nickdpz/Control-de-Rectificador-Trifasico-6-scr-s-PIC16F628A/README.md

Control de Rectificador Trifasico 6 scr s PIC16F628A. /
El sistema constara de tres etapas: 1) la etapa de control y sincronización 2) la etapa de drive y por último 3) la etapa de potencia, estas se explicarán detalladamente en el archivo PDF llamado informe, ademas se podra ver el esquema final en el archivo PDF Esquematico-Trifasico
