nickdpz/Control-de-Rectificador-Trifasico-6-scr-s-PIC16F628A/Informe.pdf

Objetivos

Generales

- Diseñar e implementar un rectificador trifásico totalmente controlado con carga resistiva y voltaje de fase 120Vrms.
- Diseñar el circuito de control de tal forma que el ángulo de disparo se pueda modificar de 0 a 180° con respecto al ángulo mínimo de disparo. De tal forma que se pueda usar para transmisión de corriente continua en configuración back to back.

Específicos

- Seleccionar los SCR’ s que permita entregar la corriente que requerida por la carga y soporte las tensiones trifásicas de bloqueo.
- Identificar los requerimientos para disparar los SCR’ s de un circuito de potencia, donde su cátodo no está referenciado a la tierra del circuito.
- Diseñar un circuito que permita identifique de las señales trifásicas el momento donde se tiene el ángulo mínimo para los disparos.
- Proponer un circuito que permita disparar de forma controlada los 6 SCR´ s del rectificador trifásico.
- Diseñar una etapa drive que de potencia a los disparos generados por la etapa de control hacia la etapa de potencia y aislé las tierras de ambas etapas.

Planteamiento del Problema
Se debe diseñar un rectificador trifásico controlado para una carga resistiva en este caso un bombillo. El nivel Tensión de trabajo Fase a Neutro es 120Vrms, y lo que se desea es la modificación manual del ángulo disparo alfa (α).

Solución

El sistema constara de tres etapas: 1) la etapa de control y sincronización 2) la etapa de drive y por último 3) la etapa de potencia, estas se explicarán detalladamente a continuación:

Etapa de Control y Sincronización

Debido a las alteraciones leves que presenta la red en cuanto a frecuencia o niveles de señal, es necesario sincronizar constantemente, de modo es muy importante para el diseño de la etapa de control cómo y en que instante del periodo de la señal nos vamos a sincronizar.

La sincronización se puede hacer en dos instantes de la señal, el primer caso sería encontrar el cruce por cero de la señal de referencia para este caso R y con un circuito análogo o digital hacer un retardo de 60° para encontrar el alfa mínimo, sin embargo, esta alternativa necesita gastar algo de recursos del circuito digital o un circuito extra análogo. Otra alternativa para diseño es un comparador entre las fases y que se active en el instante donde la fase R sea la mayor de todas, esta alternativa es la que se va a aplicar al circuito propuesto.

# Rectificador Trifásico Totalmente controlado

Nicolas David Pastran Zamora | Cod. 20151005087
Benigno Alexander Corrales | Cod. 20142005093
Universidad Distrital Francisco José de Caldas, Facultad de Ingeniería Laboratorio de Electrónica de Potencia
Bogotá, Colombia

Si notamos en la señal trifásica el instante donde R es mayor que S y que T, es el mismo donde R es mayor a T como se ve en la figura 1.

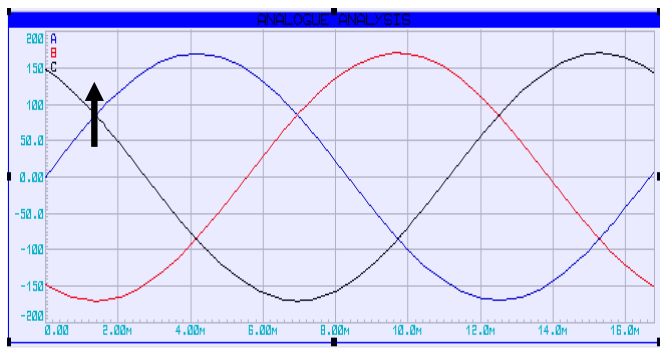
[picture p1: figure]

Figura 1: Identificación de ángulo mínimo de disparo

Para identificar ese instante usaremos un amplificador operacional como comparador con su respectivo acondicionamiento de señales.

Como la salida del operacional va a ir a la entrada de un microcontrolador este debe estar en un rango entre 0 y 5 voltios, entonces se debe seleccionar una fuente de alimentación para el operacional, aproximadamente de 6.5V, para el diseño usaremos una de 7 V y un operacional polarizado con fuente única (lm358) para que el Vol sea lo más cercano posible a 0V.

Del acondicionamiento de señales de la entrada tenemos que tener en cuenta que el rango de voltaje debe estar entre 2V y 5V, entonces se debe acondicionar las fases que están en el rango de -170 V y 170V al rango de entrada del operacional. El diseño del acondicionamiento de señales se realiza a continuación:

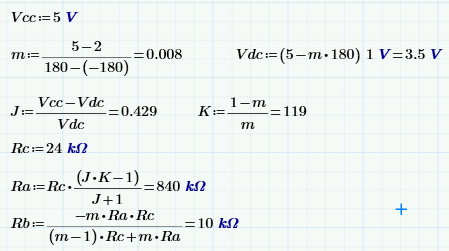
[picture p2: figure]

El circuito Resultante se puede observar en la figura 2.

Es decir, se desea reducir notoriamente la amplitud de las fases y montarlas sobre un nivel D.C. donde solo se presenten valores apropiados para el micro.

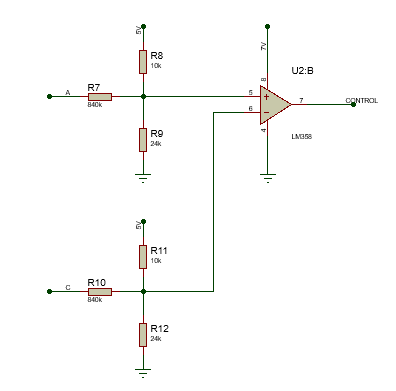
[picture p3: figure]

Figura 2: Entrada del operacional

El circuito presenta como salida un Pwm correspondiente al cruce de señales:

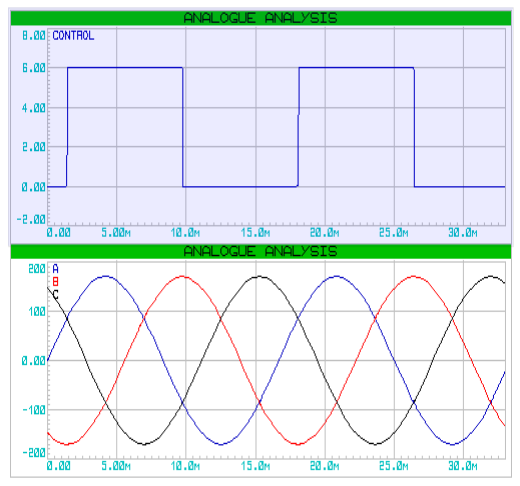
[picture p4: figure]

Figura 3: Red trifásica y salida del opAmp.

La señal de control entonces estará dada por el flanco de subida de la salida del operacional.

Una vez establecida la señal de control se realizará el diseño del circuito encargado de genera los pulsos de disparo para el ángulo seleccionado.

Como circuito encargado de generar los pulsos de disparo se usará un PIC16F628A, ya que cuenta con 2 módulos de conteo timer y módulo de interrupción externa, los cuales se usarán para detectar el flanco de subida, contar el tiempo al cual le corresponde el ángulo de disparo seleccionado y el tiempo que hay entre los pulsos de cada dispositivo. Mientras que el procesador estará encargado de contar el tiempo que duran en alto los pulsos (aproximadamente 300µs) y escuchar cuando se pulse un botón para modificar el ángulo de disparo.

Pines de los puertos A y B de dicho Pic entregaran las salidas controladas.

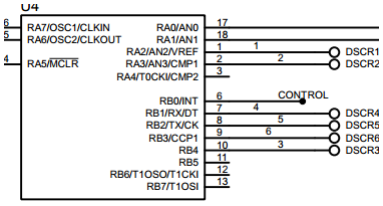
[picture p5: figure]

Figura 4: Pic16f628A

El lenguaje de mayor facilidad e implementado para la programación es C CCs orientado para microcontroladores.

En | términos | generales, | el | amplificador
operacional proporciona un flanco de subida que activa la interrupción, ésta activa un timer contador del tiempo correspondiente al ángulo alfa, culminado ese tiempo se envían pulsos y se activa un segundo timer establecido con el tiempo para la nueva orden de pulsos. Así pues, la interrupción externa garantiza el sincronismo, el primer timer garantiza un alfa variable pues se plantean botones para modificar su parámetro, y el segundo timer tiene parámetro constante y es quien establece los 60 grados entre pulsos.

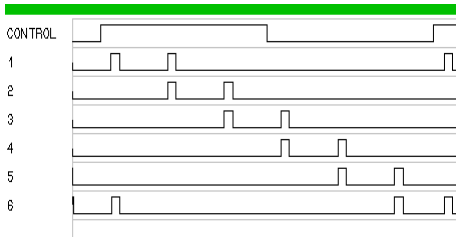
[picture p6: figure]

Figura 5: Salida del opAmp y serie de pulsos

Finalmente, para el circuito se proponen un nivel de tensión de 5 V para el Pic y 7v para el operacional

Etapa Drive:
Como para la detección de cruce señales propuesta, se conecta el neutro de la red trifásica directamente con la tierra de los niveles D.C., se hace necesario la incorporación de elementos de acople de tierras, sin contar que además es imposible conectar los pines del micro directamente a los SCR.

Se presentan transistores npn 2n904 saturados por las salidas del Pic a través de resistencias de 10K en su base. Como carga entre colector y Vcc de 7V, se tiene el primario de un transformador de pulsos. Adicionalmente se tiene como elementos de protección en paralelo al primario un diodo Zener para evitar sobretensiones, y un diodo de conmutación rápida para evitar el efecto conocido patada inductiva (diodo volante).

Así pues, el secundario garantiza una salida apropiada para la conexión con los elementos principales del rectificador los SCR, pues presenta desacople de tierras.

Para garantizar un consumo de corriente se tiene resistencias de 22K entre los terminales de la bobina de salida, y en paralelo a esta, salen un diodo que evita flancos negativos o parásitos generados por el ∆V
∆t

, y una
resistencia de 100 ohms limitando la corriente de gate. La conexión propuesta se repite 6 veces, una por cada SCR.

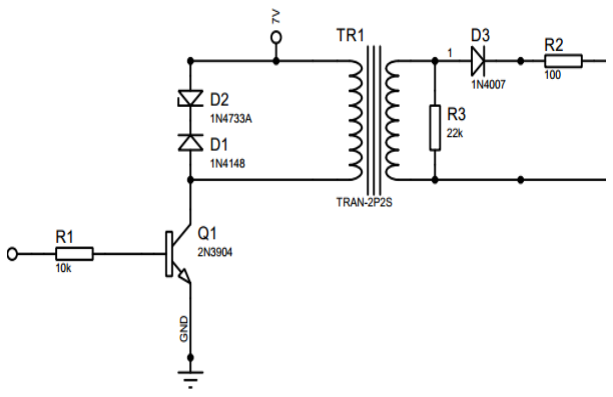
[picture p7: figure]

Figura 6: Etapa drive entre el Pic y los Scr

Etapa Potencia:
Conformada por los SCR, la referencia seleccionada son los TYN412, SCR’s con empaquetado TO-220 y capaces de trabajar con cualquier nivel de tensión no mayor a 400V .
La conexión del rectificador es la propuesta en bibliografías como “Electrónica de Potencia” de Hart, es decir la numeración impar 1,3,5 en la parte superior, y 4,6,2 en la inferior:

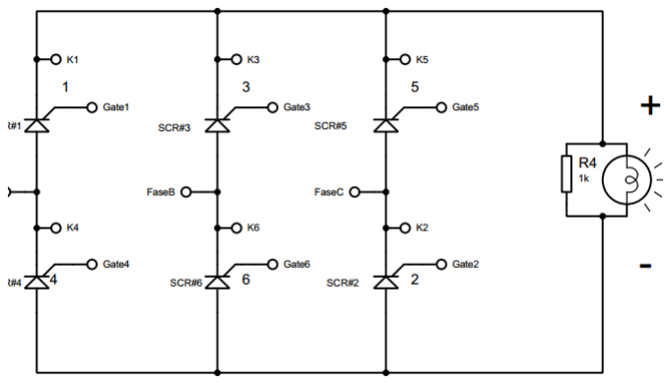
[picture p8: figure]

Figura 7: Conexión de SCR’s

Así pues, cada juego Gate-cátodo está
conectado | a | un | secundario | de | un
transformador de pulsos. Es decir, posee su propio pulso, pero la conexión no es arbitraria pues debe conectarse acorde con el que posee en su primario el pin de control específico del micro.

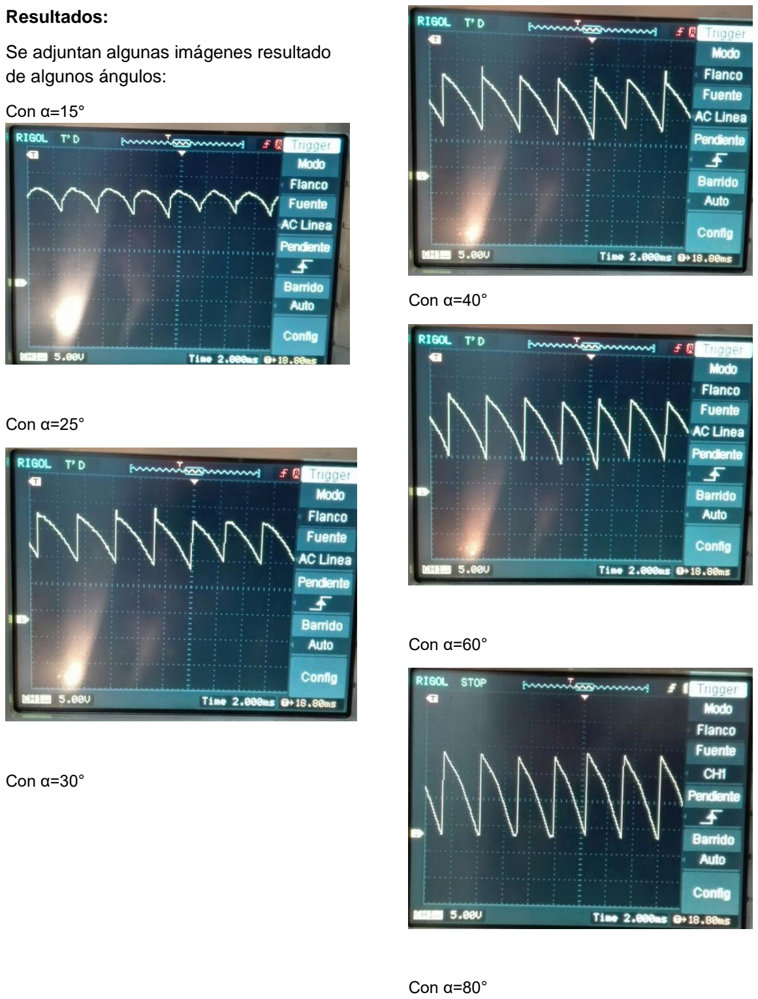
[picture p9: page 5]

Resultados:

Se adjuntan algunas imágenes resultado de algunos ángulos:

Con α=15°

Con α=25°

Con α=30°

Con α=40°

Con α=60°

Con α=80°

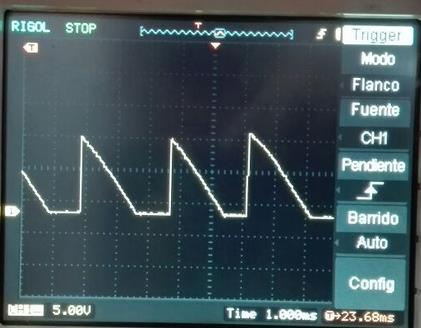
[picture p10: figure]

Conclusiones

- Se realizaron pruebas con pulso sencillo y doble pulso a la entrada de los transformadores, la mejor respuesta en el secundario de los transformadores se obtuvo con el doble pulso, pues como se incrementó la frecuencia se evitó la saturación de los mismos.
- Es importante destacar que el tiempo equivalente a los grados entre pulsos debe estar lo más exacto posible, pues
disparos | erróneos | con | retardo | o
anterioridad causan fluctuaciones e irregularidades con la señal esperada.
- Dada la frecuencia de los pulsos de disparo, es importante que los diodos en la etapa drive sean de conmutación rápida, pues cualquier retardo en tiempo de recuperación inversa aquí si es notorio.
- Los secundarios de los transformadores presentan fluctuaciones bruscas debido a la variación de voltaje, es necesario destacar la necesidad de diodos en
dicha | salida | para | eliminar | picos
negativos

Referencias:

[1]Compilador C CCS y simulador Proteus para microcontroladores PIC – Eduardo García Breijo

[2] Electrónica de potencia. Daniel W. Hart
[3] Apuntes y notas de clase

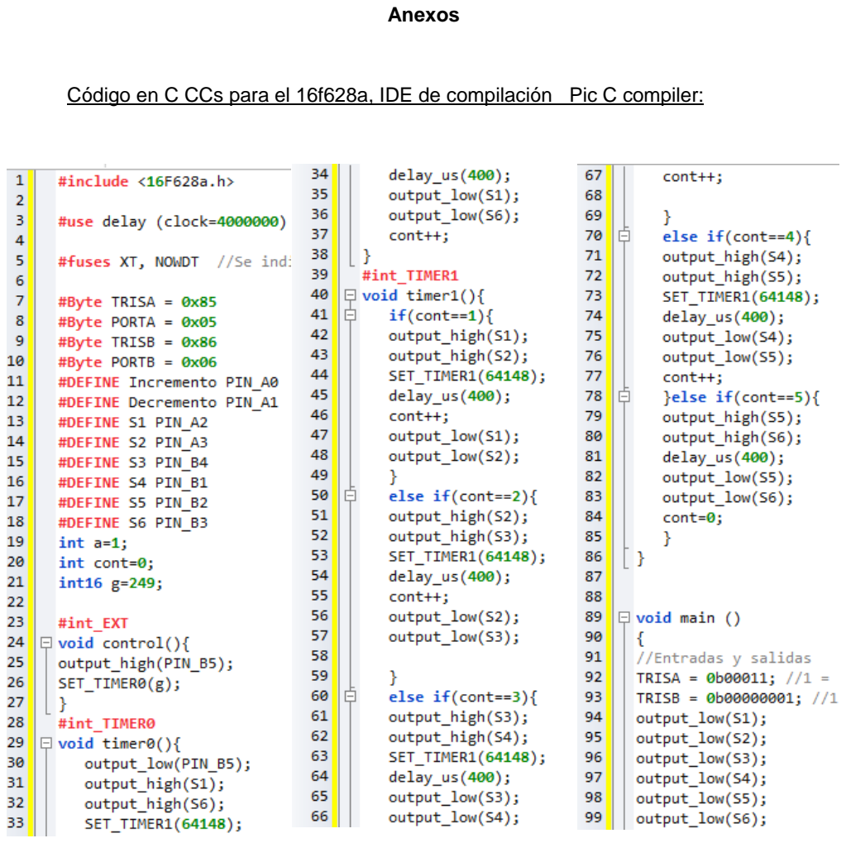
[picture p11: page 7]

Anexos

Código en C CCs para el 16f628a, IDE de compilación Pic C compiler:

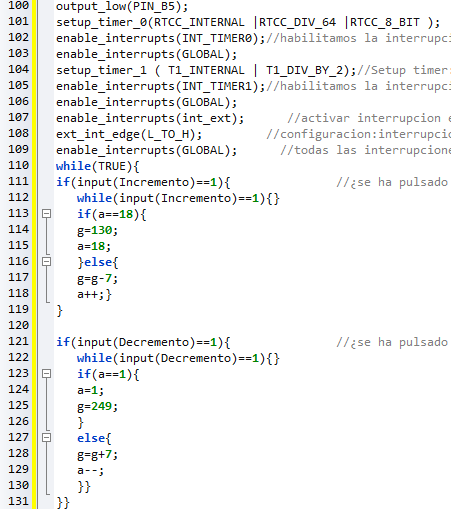
[picture p12: figure]
