nickdpz/Control-de-Rectificador-Trifasico-6-scr-s-PIC16F628A/Esquematico-Trifasico.PDF

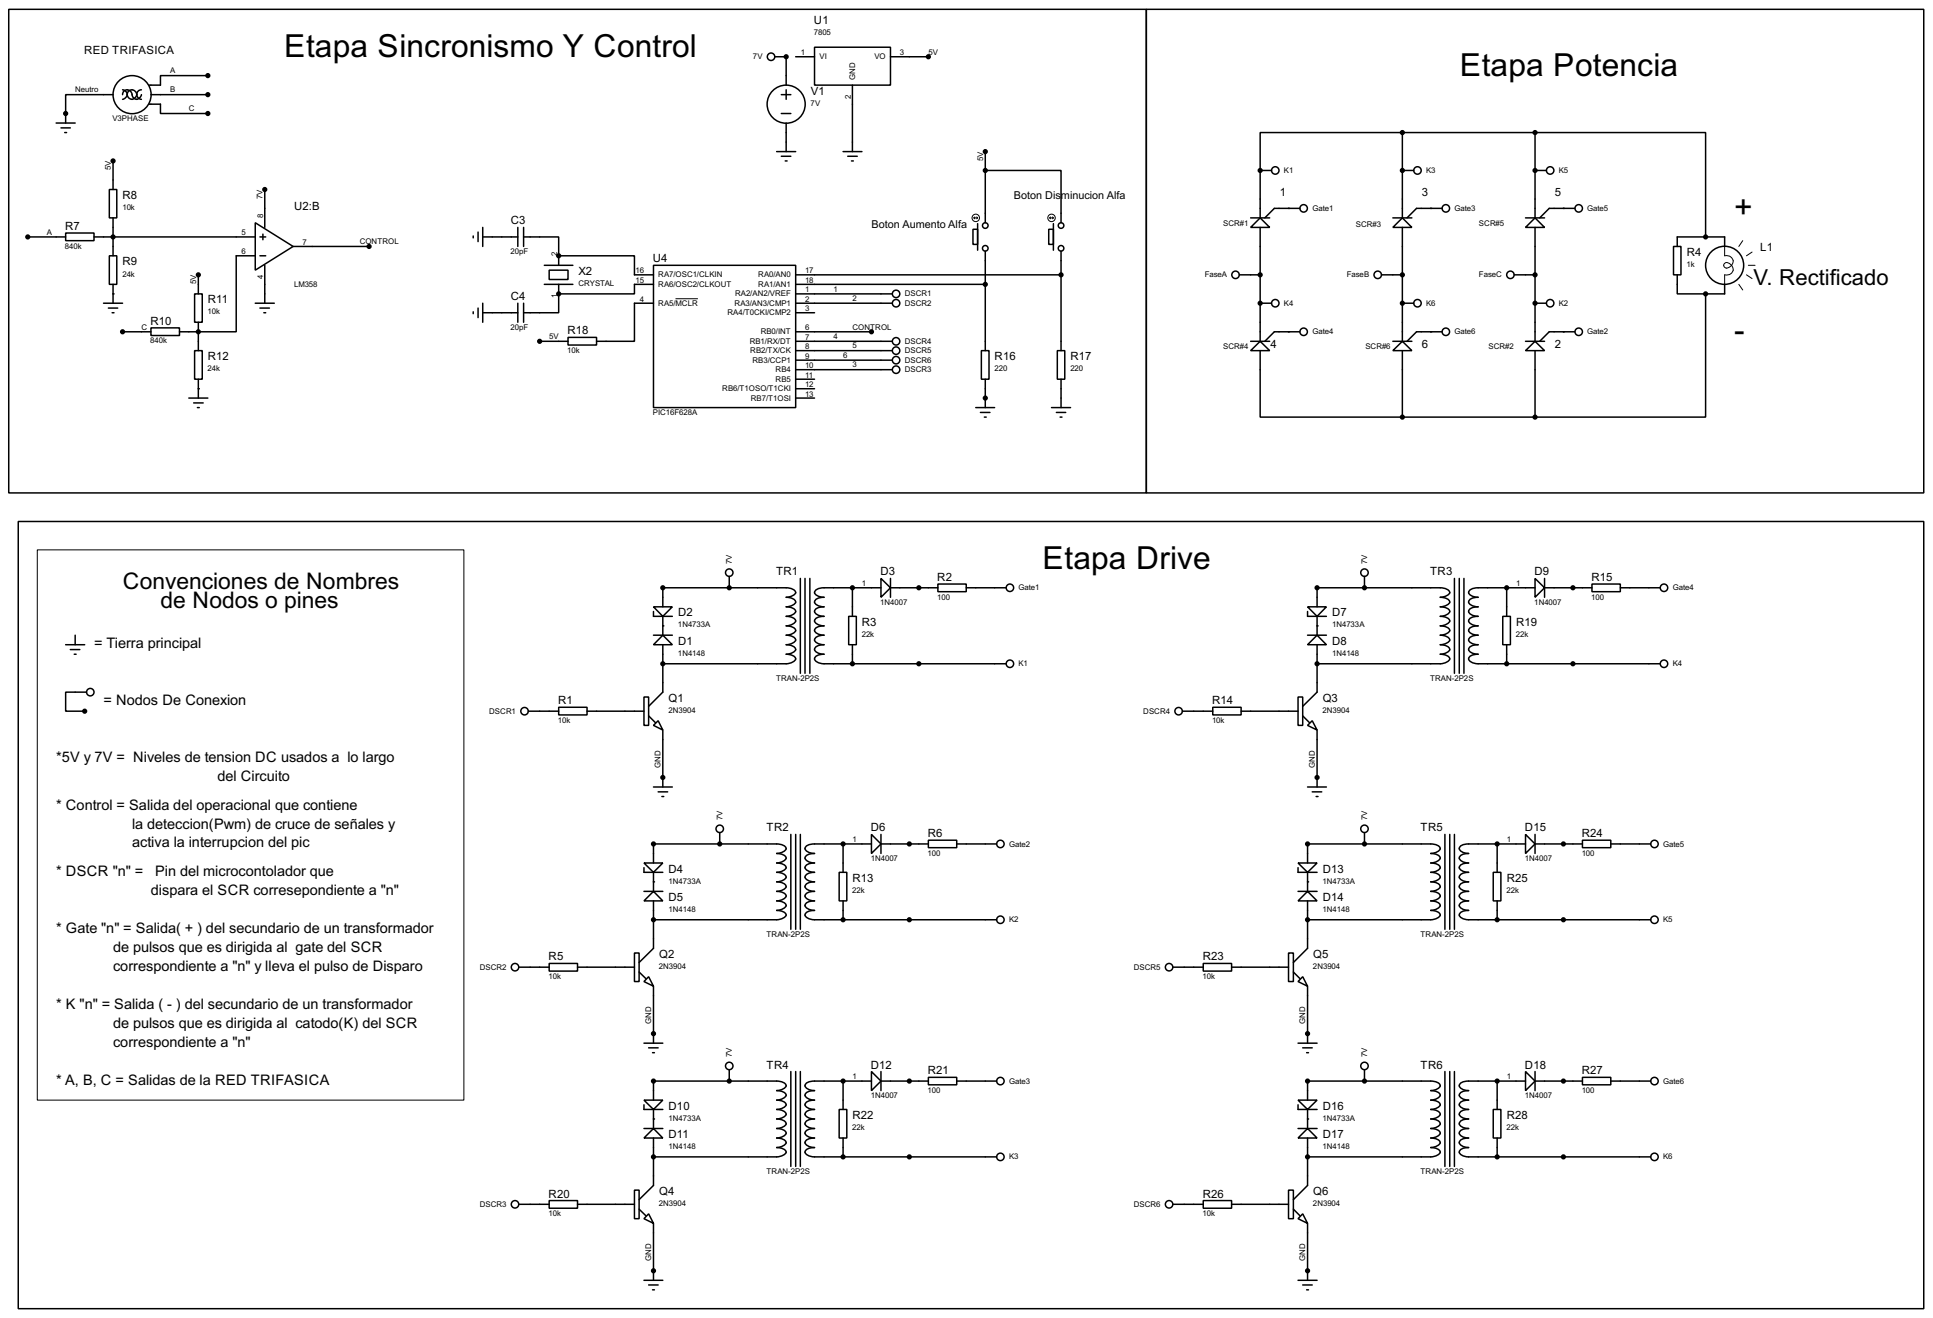
[picture p13: page 1]

*5V y 7V = Niveles de tension DC usados a lo largo

* Control = Salida del operacional que contiene

la deteccion(Pwm) de cruce de señales y
activa la interrupcion del pic

* DSCR "n" = Pin del microcontolador que

dispara el SCR corresepondiente a "n"

* Gate "n" = Salida( + ) del secundario de un transformador

de pulsos que es dirigida al gate del SCR
correspondiente a "n" y lleva el pulso de Disparo

* K "n" = Salida ( - ) del secundario de un transformador

de pulsos que es dirigida al catodo(K) del SCR
correspondiente a "n"

* A, B, C = Salidas de la RED TRIFASICA
