nickdpz/Control-de-Rectificador-Trifasico-6-scr-s-PIC16F628A/(list of files, drawings)

Other design files:
Rectificador3fasico.pdsprj
